katielin42/IMU-CANBUS-USB-PCB/IMU_project_bom.xls

Comment | Description | Designator | Footprint | LibRef | Quantity | Order?
0.1µF | C0603 | C1, C6, C7, C8, C9, C10, C16, C17, C18, C21, C22 | CAPC1608X87X35LL15T15 | CMP-2006-03741-1 | 11 | No
1µF | C0603 | C2, C4, C5, C14, C19, C20 | CAPC1608X87X35LL15T15 | CMP-2006-03741-1 | 6 | No
10µF | C0603 | C3 | CAPC1608X87X35LL15T15 | CMP-2006-03741-1 | 1 | Yes
4.7µF | C0603 | C11 | CAPC1608X87X35LL15T15 | CMP-2006-03741-1 | 1 | No
20pF | C0603 | C12, C15 | CAPC1608X87X35LL15T15 | CMP-2006-03741-1 | 2 | No
10nF | C0603 | C13 | CAPC1608X87X35LL15T15 | CMP-2006-03741-1 | 1 | No
USBLC6-2P6 | TVS DIODE 5.25V 17V SOT666 | D1 | FP-SOT-666-MFG | CMP-12225-000058-1 | 1 | No
603 | LED RED DIFFUSED SMD | D2, D3, D4 | FP-SML-LX0603SIW-TR-MFG | CMP-57192-000009-1 | 3 | No
1N5819 | DIODE SCHOTTKY 40V 1A SOD123 | D5 | FP-SOD123-IPC_A | CMP-0303-00003-3 | 1 | No
SHF-105-01-L-D-TH | CONN HEADER VERT 10POS 1.27MM | J1 | FP-SHF-105-01-L-D-TH-MFG | CMP-02766-000059-1 | 1 | No
USB4105-GF-A | CONN RCPT USB2.0 TYPEC 5A | J2 | FP-USB4105-GF-A-MFG | CMP-245163-000001-1 | 1 | No
PR20204VBDN | PIN HEADER, THR, DUAL ROW, .100" | J3 | FP-PR20204VBDN-MFG | CMP-77940-000004-1 | 1 | No
R25-1001302 | HEX STNDFF M2.5X0.45 BRASS 13MM | MP1, MP2, MP3, MP4 | FP-R25-1001302-MFG | CMP-15845-000001-1 | 4 | No
2N7002-7-F | MOSFET N-CH 60V 115MA SOT23-3 | Q1 | FP-SOT23-MFG | CMP-2000-04929-2 | 1 | Yes
10k | R0603 | R1, R2, R9 | RESC1608X55X25ML10T15 | CMP-2000-04177-1 | 3 | No
330R | R0603 | R3, R10 | RESC1608X55X25ML10T15 | CMP-2000-04177-1 | 2 | No
1k | R0603 | R4, R5, R6 | RESC1608X55X25ML10T15 | CMP-2000-04177-1 | 2 | No
5.1k | R0603 | R7, R8 | RESC1608X55X25ML10T15 | CMP-2000-04177-1 | 2 | No
1M | R0603 | R11 | RESC1608X55X25ML10T15 | CMP-2000-04177-1 | 1 | DNP
430473035826 | Switch Tactile Spst-no 0.05A 12V | SW1, SW2 | 430473035826 | CMP-1455-00006-5 | 2 | Yes
ICM-20948 | World’s Lowest Power 9-Axis MEMS MotionTracking(TM) Device, 1.71 to 3.6 V, -40 to 85 degC, 24-Pin QFN, RoHS, Tape and Reel | U1 | TDK-QFN-24_L | CMP-2000-07532-1 | 1 | Yes
STM32F103CBT6(GD32C103CBT6) | ARM Cortex-M3 32-bit MCU, 128 KB Flash, 20 KB Internal RAM, 37 I/Os, 48-pin LQFP, -40 to 85 degC, Tray | U2 | STM-LQFP48_L | CMP-0237-00250-3 | 1 | Yes
NCP164CSN330T1G | Bi-Directional Quad TVS Array, 5-Pin TSOP, Pb-Free, Tape and Reel | U3 | ONSC-TSOP-5-483-02_V | CMP-1063-00221-1 | 1 | No
LD39015M15R | 150 mA Low Quiescent Current Low Noise Voltage Regulator, 1.5V, 5-Pin SOT-23, Tape and Reel | U4 | SOT23-5L_N | CMP-0244-00342-1 | 1 | Yes
TJA1042T/3/CM,118 | IC TRANSCEIVER HALF 1/1 8SO | U5 | FP-SOT96-1-IPC_A | CMP-10098-000021-1 | 1 | No
TXB0108PWR | TXB0108 8-Bit Bidirectional Voltage-Level Translator with Auto-Direction Sensing and +/- 15-kV ESD Protection, 1.2 to 3.6 V, -40 to 85 degC, 20-Pin TSSOP (PW), Green (RoHS & no Sb/Br), Tape and Reel | U6 | PW0020A_L | CMP-2000-07337-1 | 1 | Yes
8M20P2 | ATS-SM Series Quartz Crystal, 16 MHz, -20 to 70 degC, 11.1 x 4.83 x 4.3mm SMD, RoHS, Tape and Reel | X1 | CTS-ATS-SM-XTAL-2 | CMP-0585-00002-2 | 1 | Yes
