katielin42/IMU-CANBUS-USB-PCB/LCSC__WM2601220252_20260123013554.csv

LCSC Part Number | Manufacture Part Number | Manufacturer | Customer NO. | Package | Description | RoHS | Quantity | Unit Price($) | Ext.Price($) | Estimated lead time (business days) | Date Code / Lot No.
C85049 | 2N7002-7-F | DIODES |  | SOT-23 | N-Channel 60V 210mA 370mW Surface Mount SOT-23 | YES | 20 | 0.0268 | 0.54
C14663 | CC0603KRX7R9BB104 | YAGEO |  | 0603 | 100nF ±10% 50V Ceramic Capacitor X7R 0603 | YES | 100 | 0.0021 | 0.21
C95843 | CL10B105KP8NNNC | Samsung Electro-Mechanics |  | 0603 | 1uF ±10% 10V Ceramic Capacitor X7R 0603 | YES | 50 | 0.0059 | 0.30
C726001 | ICM-20948 | TDK InvenSense |  | QFN-24(3x3) | QFN-24(3x3) IMUs (Inertial Measurement Units) RoHS | YES | 2 | 7.819 | 15.64
C2885643 | GD32C103CBT6 | GigaDevice Semicon Beijing |  | LQFP-48(7x7) | ARM Cortex-M4 120MHz 37 LQFP-48(7x7) Microcontrollers RoHS | YES | 3 | 1.6259 | 4.88
C51953300 | XTLV70318-XC | SiChange |  | SOT-23-5 | 5.5V Positive Fixed 1.8V SOT-23-5 Voltage Regulators - Linear, Low Drop Out (LDO) Regulators RoHS | YES | 3 | 0.0935 | 0.28
C53406 | TXB0108PWR | TI |  | TSSOP-20 | 100Mbps 1 8 TSSOP-20 Translators, Level Shifters RoHS | YES | 5 | 0.2449 | 1.22
C7471629 | H6OEL89CSC-SUGYLC-8M | YXC Crystal Oscillators |  | HC-49S-SMD | Crystal 8MHz ±20ppm 20pF HC-49S-SMD | YES | 5 | 0.0833 | 0.42
C2909692 | K2-1157SP-I4SW-01 | Korean Hroparts Elec |  | SMD | Pushbutton Switch Round Button Surface Mount | YES | 5 | 0.0961 | 0.48
