katielin42/IMU-CANBUS-USB-PCB/IMU_project.pdf

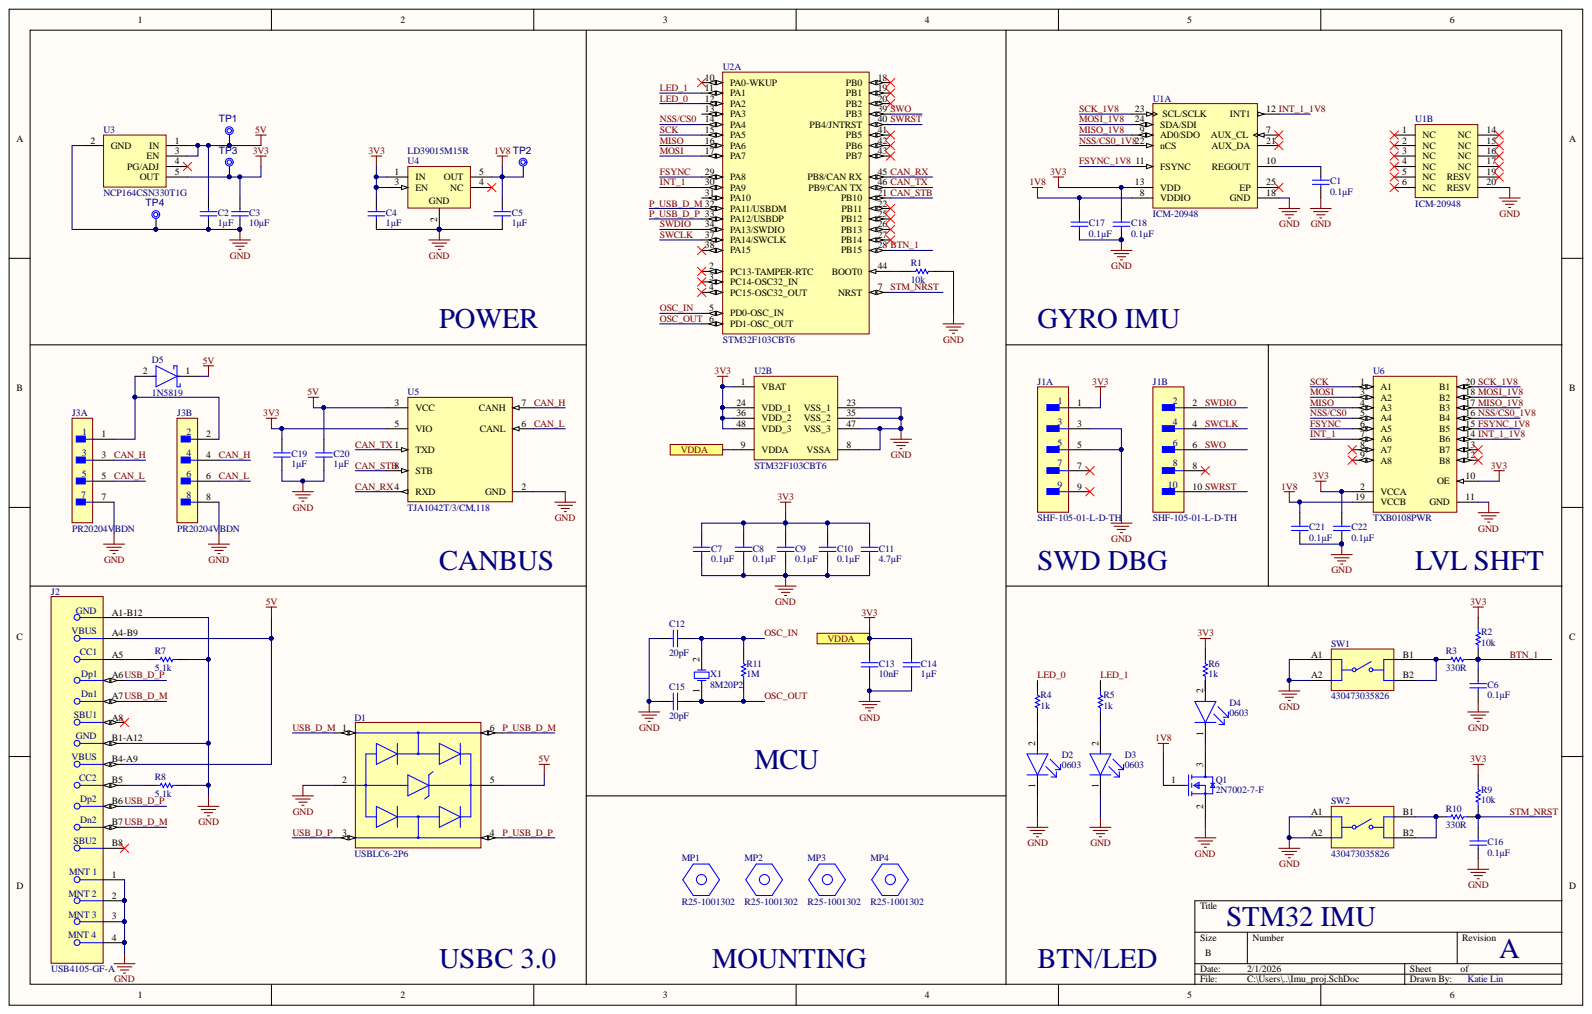
[picture p2: page 1]

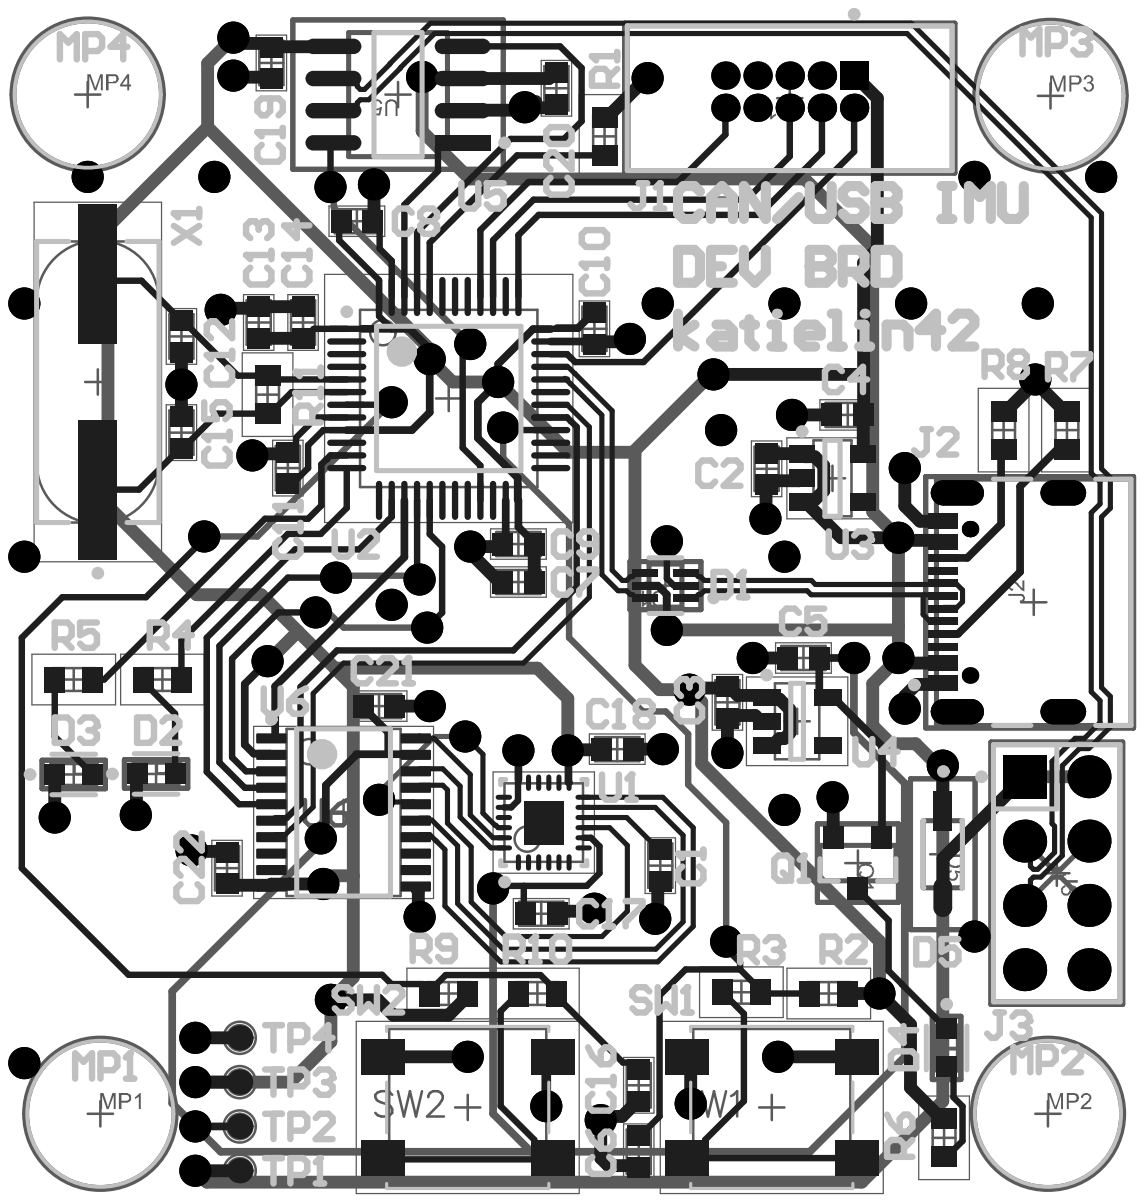
[picture p3: page 2]

Comment | Description | Designator | Footprint | LibRef | Quantity
0.1µF | | C1, C6, C7, C8, C9, C1CAPC1608X87X35LL15CMP-2006-03741-1 | | | 11
1µF | | C2, C4, C5, C14, C19,CAPC1608X87X35LL15CMP-2006-03741-1 | | | 6
10µF | | C3 | CAPC1608X87X35LL15CMP-2006-03741-1 | | 1
4.7µF | | C11 | CAPC1608X87X35LL15CMP-2006-03741-1 | | 1
20pF | | C12,C15 | CAPC1608X87X35LL15CMP-2006-03741-1 | | 2
10nF | | C13 | CAPC1608X87X35LL15CMP-2006-03741-1 | | 1
USBLC6-2P6 | TVS DIODE 5.25V 17VD1 | | FP-SOT-666-MFG | CMP-12225-000058-1 | 1
0603 | LED RED DIFFUSED SD2, D3, D4 | | FP-SML-LX0603SIW-TCMP-57192-000009-1 | | 3
1N5819 | DIODE SCHOTTKY 40D5 | | FP-SOD123-IPC_A | CMP-0303-00003-3 | 1
SHF-105-01-L-D-TH | CONN HEADER VERT 1J1 | | FP-SHF-105-01-L-D-TCMP-02766-000059-1 | | 1
USB4105-GF-A | CONN RCPT USB2.0 TJ2 | | FP-USB4105-GF-A-MFCMP-245163-000001-1 | | 1
PR20204VBDN | PIN HEADER, THR, DUJ3 | | FP-PR20204VBDN-MFGCMP-77940-000004-1 | | 1
R25-1001302 | HEX STNDFF M2.5X0.4MP1, MP2, MP3, MP4 FP-R25-1001302-MFGCMP-15845-000001-1 | | | | 4
2N7002-7-F | MOSFET N-CH 60V 11Q1 | | FP-SOT23-MFG | CMP-2000-04929-2 | 1
10k | | R1, R2, R9 | RESC1608X55X25ML1CMP-2000-04177-1 | | 3
330R | | R3,R10 | RESC1608X55X25ML1CMP-2000-04177-1 | | 2
1k | | R4, R5, R6 | RESC1608X55X25ML1CMP-2000-04177-1 | | 3
5.1k | | R7,R8 | RESC1608X55X25ML1CMP-2000-04177-1 | | 2
1M | | R11 | RESC1608X55X25ML1CMP-2000-04177-1 | | 1
430473035826 | Switch Tactile Spst-noSW1,SW2 | | 430473035826 | CMP-1455-00006-5 | 2
ICM-20948 | World’s Lowest Power U1 | | TDK-QFN-24_L | CMP-2000-07532-1 | 1
STM32F103CBT6 | ARM Cortex-M3 32-bitU2 | | STM-LQF P48_L | CM P-0237-002 50-3 | 1
NCP164CSN330T1G | Bi-Directional Quad TVU3 | | ONSC-TSOP-5 -483-02CMP-1063-00221-1 | | 1
LD39015M15R | 150 mA Low QuiescenU4 | | SOT23-5L_N | CMP-0244-00342-1 | 1
TJA1042T/3/CM,118 | IC TRANSCEIVER HALFU5 | | FP-SOT96-1-IPC_A | CMP-10098-000021-1 | 1
TXB0108PWR | TXB0108 8-Bit | U6 | PW0020A_L | CMP-2000-07337-1 | 1
8M20P2 | ATS-SM Series QuartzX1 | | CTS-ATS-SM-XTAL-2 | CMP-0585-00002-2 | 1
