katielin42/IMU-CANBUS-USB-PCB/Imu_proj.pdf

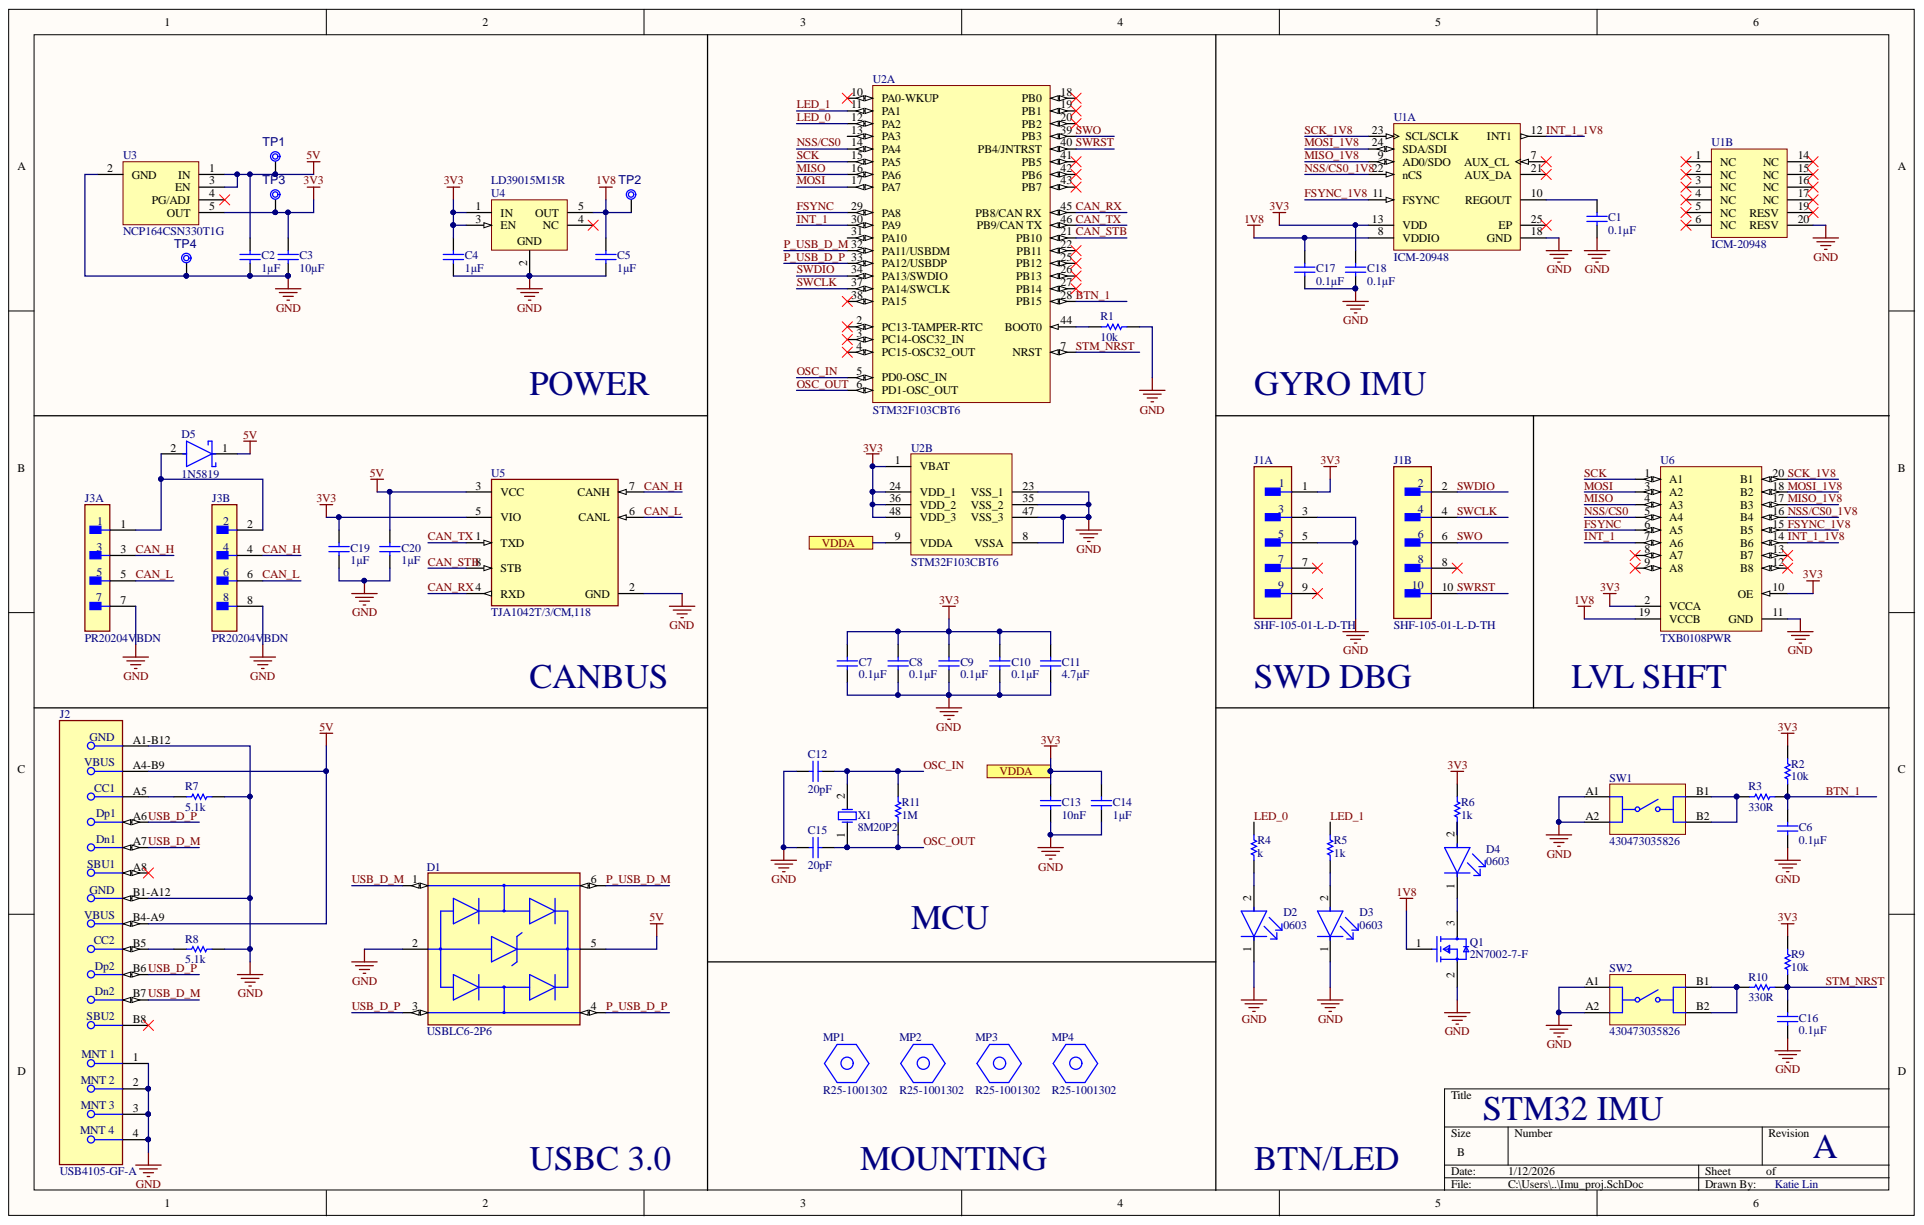
[picture p4: page 1]

C | | SWD DBG | LVL SHFT | C

# Board Stack Report
