katielin42/IMU-CANBUS-USB-PCB/(list of files, drawings)

Other design files:
Imu_proj.SchDoc
imu_proj_3.PcbDoc
IMU_project.PrjPcb
