katielin42/IMU-CANBUS-USB-PCB/(commit log)

2026-01-13 IMU proj schematics and layout
    [IMU_project.PrjPcb, Imu_proj.SchDoc, Imu_proj_BACKUP.SchDoc, PCB1.PcbDoc, imu_proj.PcbDoc, imu_proj_3.PcbDoc, imu_proj_BACKUP.PcbDoc]
2026-01-14 added .gitignore, README.md
    [Imu_proj_BACKUP.SchDoc, PCB1.PcbDoc, imu_proj.PcbDoc, imu_proj_BACKUP.PcbDoc]
2026-01-21 output gerbers, minor layout corrections
    [IMU_project.PrjPcb, imu_proj_3.PcbDoc]
2026-01-22 bom changes
    [IMU_project_bom.xls, LCSC__WM2601220252_20260123013554.csv]
2026-10-13 Add prototype image to README
    Added a prototype image to the README.
2026-10-13 Update README with prototype note and firmware link
    Clarified note about the prototype's level shifter banks and added a link to the firmware repository.
2026-10-13 Enhance README with USB-C and CANBUS details
    Expanded the description to include details about USB-C and CANBUS functionality.
2026-10-13 Update README with Rev B comments
    Added comments for Rev B addressing prototype issues and improvements.
